Oscilous/Ladybug/README.md

# Ladybug
SDU 4th semester project group 6
Members:
Tobias
Artis
Johan
Thor
Ruta
Choyon
