Oscilous/Ladybug/LaTeX/Report/main.tex

\documentclass[a4paper,12pt]{article}
\usepackage[a4paper, top = 2.5cm, bottom = 2.5cm, left = 2.5cm, right = 2.5cm]{geometry}
\usepackage{graphicx} % Required for inserting images
\usepackage{float}
\usepackage{setspace}
\usepackage{url}
%\usepackage{minted}
\usepackage{booktabs}
\usepackage{geometry}
\usepackage{parskip}
\usepackage{ragged2e}
\usepackage{subfig}
\usepackage{cite}
\usepackage[svgnames, dvipsnames]{xcolor}
\usepackage{tikz}   
\usepackage{makecell, tabularx}
    \setcellgapes{2pt}
    \makeatletter
    \newcommand*{\compress}{\@minipagetrue}
    \makeatother
    \newcolumntype{I}{ >{\RaggedRight\compress\itemize}X<{\enditemize}}
    \newcommand*{\mcl}[1]{\multicolumn{1}{l|}{#1}}
\usepackage[skip=1ex]{caption}
\usepackage{enumitem}\usepackage{tabularx}
\usepackage[utf8]{inputenc}
\usepackage[T1]{fontenc}
\usepackage{amsmath}
\usepackage{pdfpages}
\usepackage{wrapfig}

\graphicspath{ {./pictures/} }
\onehalfspacing

\begin{document}

\begin{titlepage}

\begin{tikzpicture}[remember picture,overlay]
   \node[anchor=south east,inner sep=20pt] at (current page.south east)
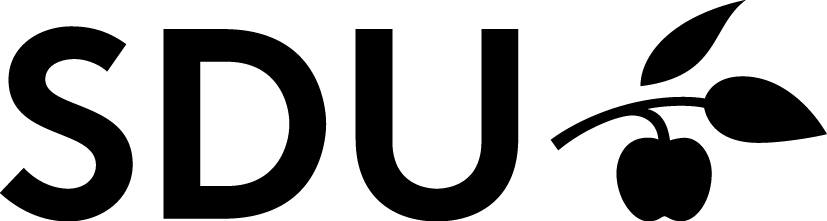
[picture p1: LaTeX/Report/pictures/sdulogo.jpg]
              {};
\end{tikzpicture}

\begin{center}

\noindent \textbf{BEng Mechatronics}

\noindent \textbf{University of Southern Denmark Sønderborg}

\Huge \bfseries{Semester Project 4 - Ladybug}

\end{center}

\begin{center}

\vspace*{0.1cm}

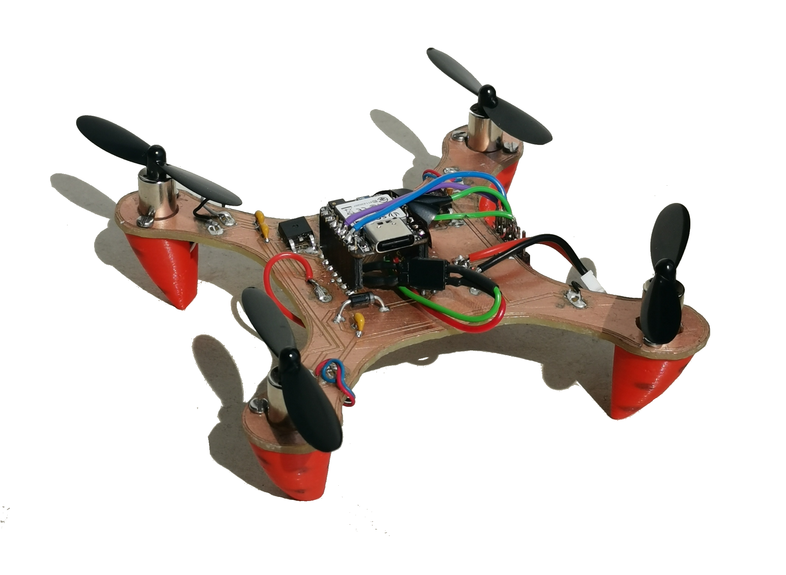
[picture p2: LaTeX/Report/pictures/FPP.png]
	

	\noindent \textbf{Ruta Miglava, }
	\noindent \textbf{Johan Paul, }
	\noindent \textbf{Choyon Mainul Hasan, }
	\noindent \textbf{Thor Uerkvitz, }
	\noindent \textbf{Artis Fils, }
	\noindent \textbf{Tobias Blaabjerg Karlsen}

	\vspace*{2cm}

\end{center}

\begin{center}

	\noindent \textbf{Supervised}
	\noindent \textbf{By}
	\vspace*{0.1cm}

	\noindent \textbf{Lars Duggen}

	\noindent \textbf{Davi Goncalves Accioli}

	\vspace*{1.5cm}

	\noindent \textbf{June 2023}	

\end{center}

\end{titlepage}

\tableofcontents
\newpage

\include{introduction/background.tex}
\input{introduction/problem_statement.tex}
\input{introduction/morpho.tex}
\input{introduction/evaluation_matrix.tex}
\input{introduction/risk_assesment.tex}

\include{software/github.tex}
\input{design/Drone_body.tex}
\input{control/plant_equations.tex}
\input{control/Controller.tex}
\input{control/uavtoolbox.tex}
\input{control/theoryofpid.tex}
\input{control/linearization.tex}
\input{control/simulationofpid.tex}
\input{control/pid.tex}

\input{IMU/IMU.tex}

\include{software/embeded.tex}
\input{software/quickpid.tex}
\input{software/logging.tex}
\input{software/Wireless.tex}
\input{software/flow.tex}
\include{conclusion/conclusion.tex}
\pagebreak
\bibliographystyle{plain}
\bibliography{references}

\appendix
\include{control/thrust_experiments.tex}
\include{control/Motor_Testing.tex}       
\include{introduction/Budget.tex}
\include{software/zephyr.tex}
\include{control/Plant_equations_appendix.tex}
\end{document}
