Oscilous/Ladybug/LaTeX/Report/control/plant_equations.tex

\section{Control prototyping}
\subsection{Plant Model Equations}\label{plant_eq}
This section of the report will explain how the plant model equations are obtained. Followed by how these equations are implemented in MATLAB/Simulink.

The plant model is a series of equations with multiple variables, which uses inputs, states, and parameters to get a certain output. 
For this project, the plant model is designed to take a height input the drone should hover at, paired with the inputs from the sensors, to achieve the desired hover height and stability.

\subsubsection{State Equations}
The drone possesses 6 degrees of freedom, enabling it to navigate in various directions and perform rotations. It can move along the X, Y, and Z axes, while also being capable of pitch (rotation around the Y axis), roll (rotation around the X axis), and yaw (rotation around the Z axis). The precise angle and position of the drone can be defined at any time by identifying the axis of rotation and its accompanying state variables.
\cite{Ferry}

\begin{figure}[H]
\begin{center}
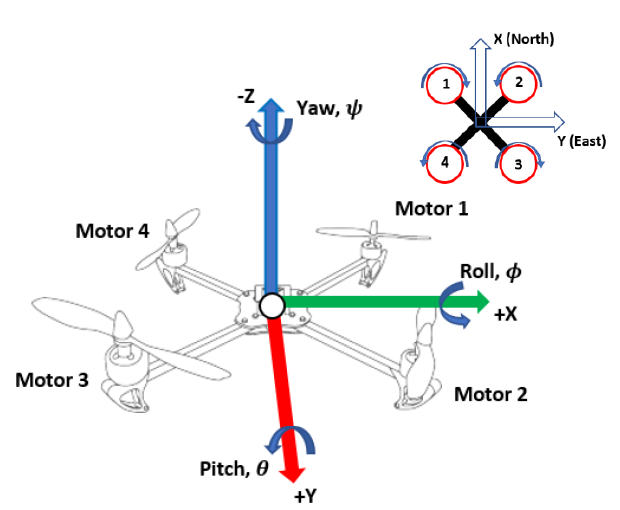
[picture p8: LaTeX/Report/pictures/control/drone directionals.png]
    
\end{center}
\caption{Quadcopter 'x' configuration \cite{Ferry}}
\end{figure}

The drone's states include critical physical properties like acceleration, velocity, and position, which are all detected by sensors. A gyroscope is used to record the angular changes of the drone. An accelerometer is a device that measures acceleration along the X, Y, and Z axes. Since the gyroscope drifts and the accelerometer has measurement spikes when subjected to high acceleration, a complementary filter will be needed, which will be discussed in the “IMU” subsection. A dedicated infrared sensor is also used to measure distances in the Z-direction, allowing for exact location information.
A state table can be found in Appendix E.

Before plant model equations can be generated, parameters for the drone need to be calculated. The parameters are what explains the drone mathematically and are an integral part of modelling the drone. The more accurate these values are the more realistic the plant model will be.
The parameters needed can be seen in the table below:\cite{Ferry}

\begin{figure}[H]
\begin{center}
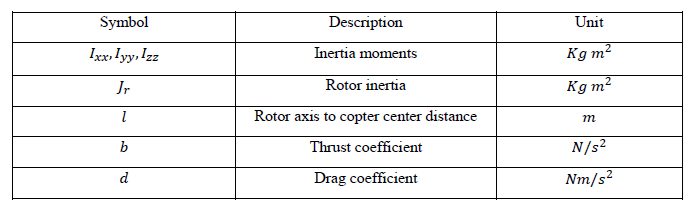
[picture p9: LaTeX/Report/pictures/control/parameter table.png]
    
\end{center}
\caption{State table}
\end{figure}

\subsubsection{Inertia Moments}
A moment of inertia is a constant value that explains the force/torque required to rotate an object in the direction of the moment. A desired angular velocity around a rotation axis can be found. The moments of inertia are found using estimation. If it is assumed that the drone is symmetrical in all axis, the moments of inertia can be found using parallel axis theorem to approximate the moments for each individual part of the drone in the X, Y, Z directions. For the calculations it’s assumed that the centre of mass for the drone is perfectly in the centre of the drone’s body.
The equations used for each individual part of the drone can be found in \cite{Ferry}.

For the approximation smaller electrical components were not considered, such as wires and mosfets, since their collective total weight is less than a gram, they are deemed negligible for the accuracy estimation.

\begin{figure}[H]
\begin{center}
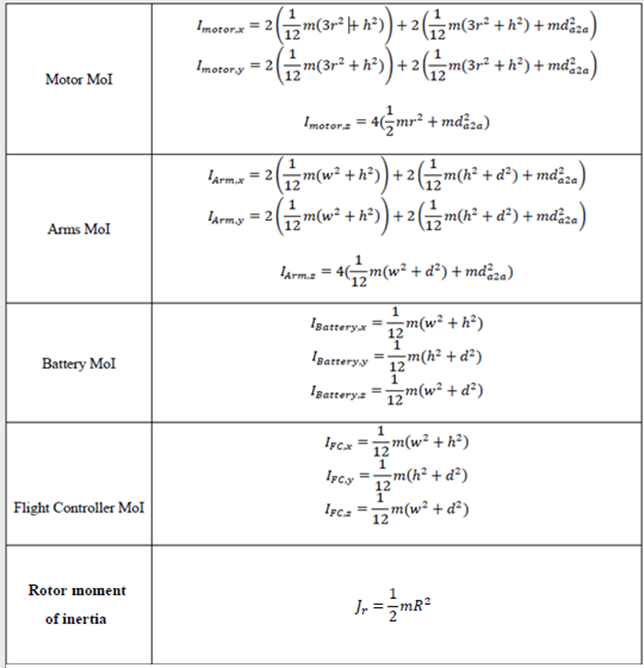
[picture p10: LaTeX/Report/pictures/control/inertia tables table.png]
   
\end{center}
\caption{Inertia moment equations \cite{Ferry}}
\end{figure}

A mathematical document can be found as a hand-in attachment “SPRO4math”. It shows the detailed process of calculation.
\begin{figure}[H]
\begin{center}
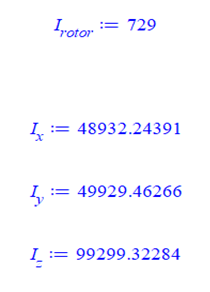
[picture p11: LaTeX/Report/pictures/control/Inertia moments.png]
   
\end{center}
\caption{Moments of inertia in the X, Y, Z axis, in $g*mm^2$ as calculated from equations, used in the final version of the quadcopter}
\end{figure}

\subsubsection{Characterization of Motor}
Some drone parameters can not be determined due to a lack of data concerning the motors used in the project. The motors are of a commercial product, but with no available data sheet. This means that motor constants and thrust coefficients need to be determined through testing. 
The next part of the report is a small summary of the tests done to determine the data needed for the motors. The full reports concerning testing and acquiring these values can be found in the appendix. 
\begin{itemize}
    \item Thrust testing can be found in appendix \ref{appendix_thrust}.
    \item Motor constant testing can be found in appendix \ref{Motor Testing_Appendix}.
\end{itemize}

\subsubsection{Thrust testing}

For thrust testing the motor is placed in a frame on a scale to measure the change in weight when the motor is operating. A sketch of the setup can be found in appendix \ref{appendix_thrust}2.2. The motor used had an operating voltage window of 0-4,2 volts, therefore the motor was tested between 1-4,2 volts incremented with 0,1 volts, and the weight change noted for each increment. Characterizing the motor yielded the results seen in figure \ref{motorthrustgraphed}. As a general rule of thumb, provided by project supervisors, the motor's need to produce double the thrust of the total weight of the drone to operate ideally. At maximum voltage level of the battery, a single motor produces 22.2 grams of thrust. In conclusion, at maximum voltage level the drone can ideally weigh 44.4 grams in total. The battery will slowly discharge meaning that it's impossible to always have max output, so it should be a little less than 44.4 grams in practice.

\begin{figure}[H]
\begin{center}
   
\end{center}
\caption{Motor Thrust Graphed}
\label{motorthrustgraphed}
\end{figure}

\subsubsection{Motor Constants, and Thrust Coefficient}
Motor constants relevant for this project include, “Motor velocity constant” ($K_v$) and “Motor torque constant” ($K_T$)
With a simple setup the motor's RPM can be tested proportionally to PWM. The motor was tested in 20 increments, using a photo sensor to measure RPM. Using the data from the test, the result is shown in figure \ref{motorconstantscals}. \cite{MotorConstants}

\begin{figure}[H]
\begin{center}
   
\end{center}
\caption{Equations used for calculating thrust- and velocity constants}
\end{figure}

\begin{figure}[H]
\begin{center}
   
\end{center}
\caption{Motor Constants}
\label{motorconstantscals}
\end{figure}

Combining the two test data sets it is possible to determine the thrust coefficient of the motor. Using the graph from the thrust test, the thrust can be calculated by taking the voltage drop over the motor. This thrust is then divided with the angular velocity to get the thrust coefficient ($TC=3.59E-05$).

The constants/coefficients are calculated around 3.0V inputs, which is the voltage needed to achieve the theoretical hover thrust. This is sensible since most of the time the drone will be operating around these values. 

\subsubsection{Environmental Forces}
The drone is very small, weighing only approximately 60 grams with little surface area. Because of this, aerodynamic effects have been neglected for the modelling. Environmental forces mainly include but are not limited to wind resistance and liftoff turbulence.

\subsubsection{Generating Plant Model Equations}
Now with the all the states and parameters defined, plant model equations can be generated. 
First, it is considered how the motors should operate together to move the quadcopter in the desired direction. A quadcopter can move in X and Y directions using pitch and roll. When the quadcopter rotates around one of its axis, all the rotor blades will generate thrust at an angle, moving the drone in a direction. It is important to control the individual motors so the drone won’t tilt too much, causing it to flip in the air. In figure \ref{ter} below the different cases of directional movement for the quadcopter can be seen.  

\begin{figure}[H]
\begin{center}
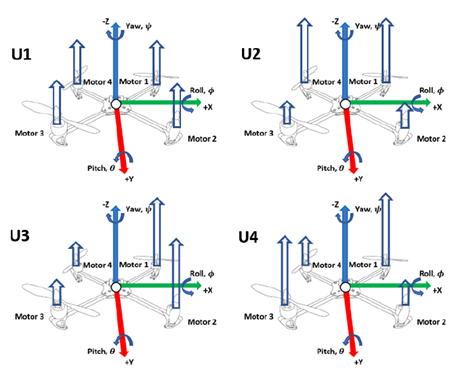
[picture p12: LaTeX/Report/pictures/control/thrust equations results.png]
   
\end{center}
\caption{Visual representation of thrust equations \cite{Ferry}}
\label{ter}
\end{figure}

In figure \ref{ter} U1 is the general thrust behaviour, providing thrust equally and symmetrically to move only the Z axis. U2 creates a roll, thrusting the drone in the Y direction. U3 creates a pitch, thrusting the drone in the X direction. U4 increases the thrust for motors turning the same direction and decreases the thrust of the motors rotating the opposite direction, allowing the drone to rotate in the Z axis e.g., yaw due to non-symmetrical rotational forces created by the moments of the motors.  \cite{Ferry}

Each motor's thrust is then defined as angular rotational speed to acquire the following equations.

\begin{figure}[H]
\begin{center}
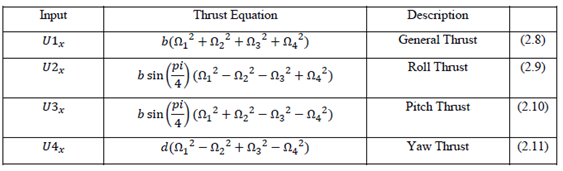
[picture p13: LaTeX/Report/pictures/control/thrust equations.png]
   
   
\end{center}
\caption{Thrust equations \cite{Ferry}}
\end{figure}

The plant equations for this project were sourced from \cite{Ferry}. The source has a more in depth description of how the plant equations were found.
A summary of all the plant equations can be found in appendix \ref{appendix_plant}.

\begin{figure}[H]
   \begin{center}
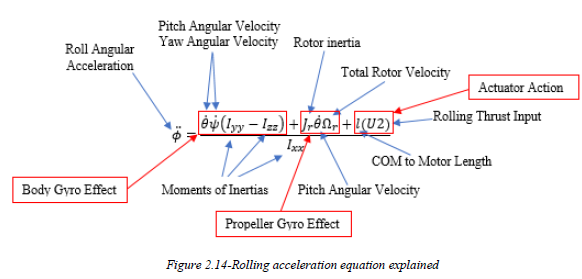
[picture p14: LaTeX/Report/pictures/control/plant equation example.png]
      
   \end{center}
   \caption{Example of plant equation for phi. \cite{Ferry}}
   \end{figure}
Body gyroscopic effects from changes in the quadcopter orientation.
Propeller gyroscopic effects from propeller rotation and angle/orientation.
Actuation action forces produced by the rotors/propellers.

\subsubsection{SIMULINK/Matlab Implementation}
To make the Simulink model the thrust equations must be transferred into the program using the angular speed as inputs and the motor parameters. Below the thrust equations can be seen in Simulink with the inputs on the left and outputs on the right. (The outputs are U1, U2, U3, and U4, as well as Omega) In SIMULINK the math is done using “blocks”, the addition and subtraction is performed first, and then the next blocks take the product. Essentially the math is converted using blocks in SIMULINK.

\begin{figure}[H]
\begin{center}
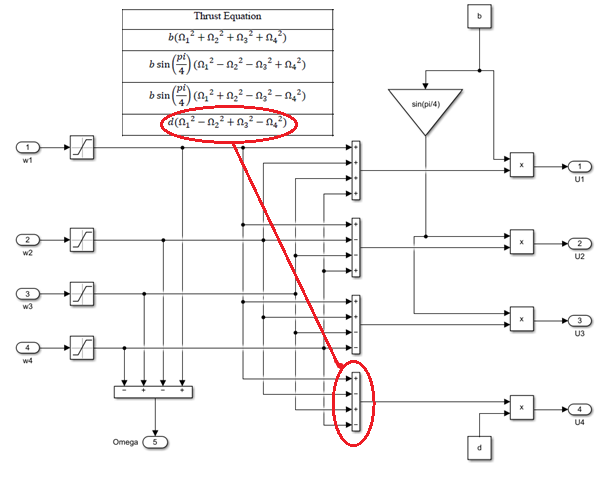
[picture p15: LaTeX/Report/pictures/control/thrust equation in simulink.png]
   
\end{center}
\caption{Thrust equations in SIMULINK}
\end{figure}

The rest of the plant equations are then also transferred to SIMULINK using the same process, using blocks to represent the math. The next part of the plant takes the thrust equations as an input to calculate theta, phi, and psi, for position, velocity, and acceleration.

Below is an example for the equation of phi double dot. The thrust equations were used alongside feedback with the drone parameters to get the result. Since all the equations need feedback from the other plant equations, an initial value must be set. It makes sense to make the initial value 0 since it hasen't moved yet and there has been no change in any direction or angle. Throughout the flight the drone will then fill out the theta, phi, and psi values using the sensors to determine the change in position. For example, if the drone is slanted a bit in the direction of motor 4 and 1, the drone will have a change in the roll aka phi value. The sensor will detect the magnitude of this change, and U2 will increase to give more thrust to those motors to stabilize. Thrust is increased proportionally in order smoothen the stabilization. 

\begin{figure}[H]
\begin{center}
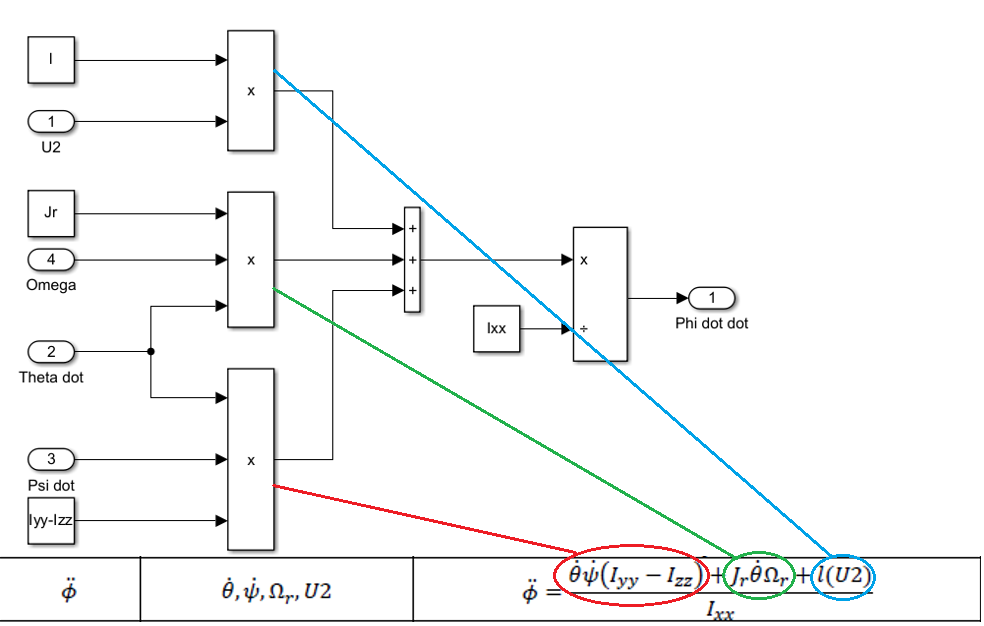
[picture p16: LaTeX/Report/pictures/control/plant equation phi example.png]
   
\end{center}
\caption{Plant equation for phi double dot}
\end{figure}

\begin{figure}[H]
\begin{center}
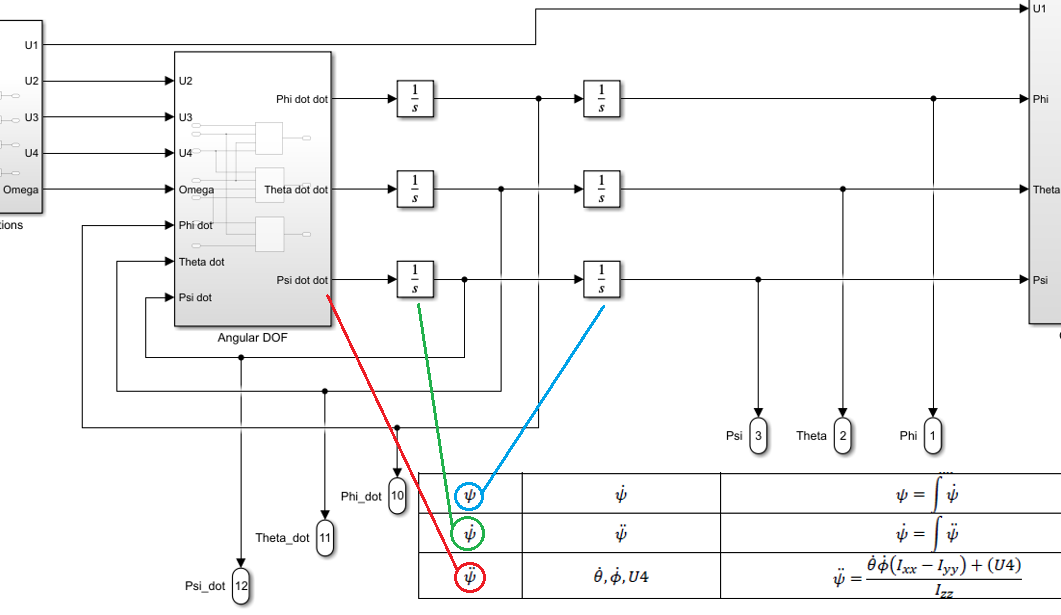
[picture p17: LaTeX/Report/pictures/control/plant pic1.png]
   
\end{center}
\caption{Angular equations overview example}
\end{figure}

To finish out the plant, the X, Y, and Z values for acceleration, velocity, and position are calculated using the values from theta, phi, and psi, these equations rely on feedback from each other in the same way that angles do, and use the same principles when it comes to determining the initial value. 

\begin{figure}[H]
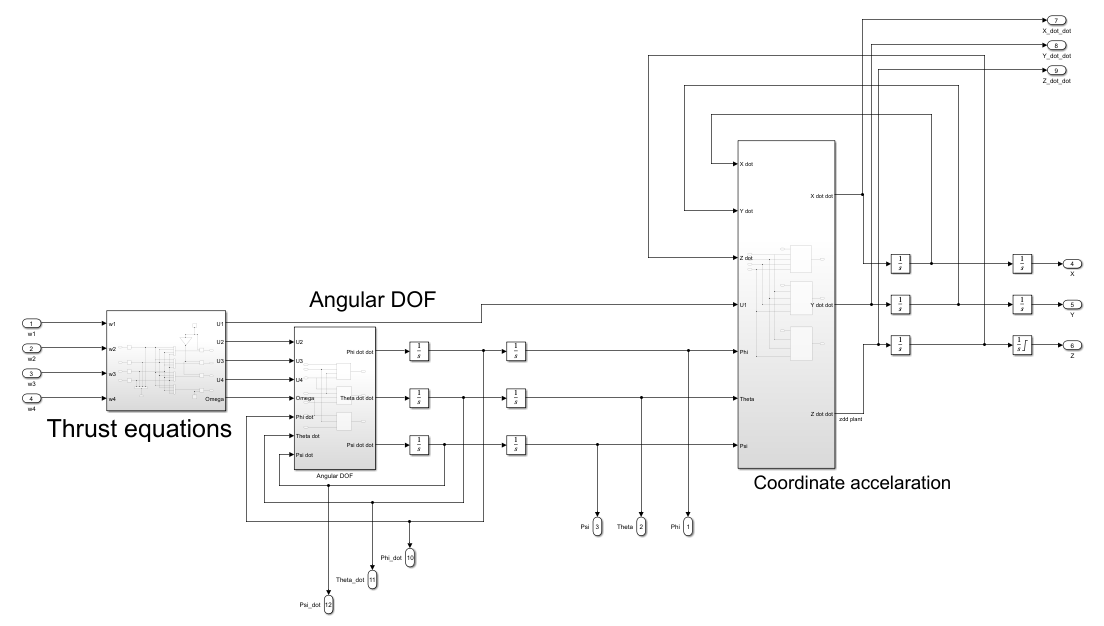
[picture p18: LaTeX/Report/pictures/control/Plant overview.png]
   
\caption{Plant overview in SIMULINK}
\end{figure}
