Oscilous/Ladybug/LaTeX/Report/software/Wireless.tex

\subsection{Wireless communication}
When prototyping, quadcopters are able to easily disconnect their wired connection. Therefore if mid-air communication is required, it is necessary to have wireless communication.

Commonly used communication for drones are primarily various forms of 2.4 GHz protocols, as it provides the best middle ground between reach and speed. The 2.4 GHz has wide range of technologies supporting it, for example, Bluetooth, Wi-Fi and RF communication protocols. 
If a high performance drone was the goal, RF communication would have been chosen, but for the purpose of this project Bluetooth or rather BLE is optimal, as the microchip has inbuild capability of BLE, which stands for Bluetooth low energy. BLE has lower power requirements, as it is primarly one way communication, where the packets are not being sent constantly, but only when needed or requested.

The implementation of BLE for nRF52840 in Arduino IDE usually relies on either Bluefruit LE or Adafruit BLE library, depending on whether pure C or Mbed is used.
For a device to use BLE, it needs to be either peripheral, which advertises itself or central, which connects to the advertised peripheral. Peripheral has services, for example control service, which can have characteristics like state with 0 and 1 for turning on and off.
This characteristic can have different options. Write, where the central writes to this characteristic, read if central reads from it and notify which lets the central know, that it changed. Also a combination of these can define each characteristic.

In this case, the drone was chosen as a peripheral with characteristics mentioned above. A controller with a joystick and two buttons connects to the peripheral as the central and writes to the characteristics. This was not used in the project, as the project did not reach stages requiring advanced remote control.
 
Instead, there is a kill-switch. This was made for the initial free-flight testing. It contains only one characteristic, which switches between 0 and 1 no matter what it receives, which starts the drone on 0 and stops on 1. It can be controlled from a mobile phone. The option of sending gyro-data from a phone to the drone to mimic a controller was also explored, but required packet management, as the data packets sent were too long.

Last option which was explored was logging data through BLE. The challenging part is that BLE is aimed mainly at mobile device and proprietary applications. Therefore there are no available applications for Windows which allow reading data from BLE devices and mobile phone applications do not offer the option of saving larger amounts of data. As a consequence of mentioned, data-logging through BLE was abandoned.
