Oscilous/Ladybug/LaTeX/Report/control/Plant_equations_appendix.tex

\section{Plant Appendix}\label{appendix_plant}

\begin{figure}[H]
   \begin{center}
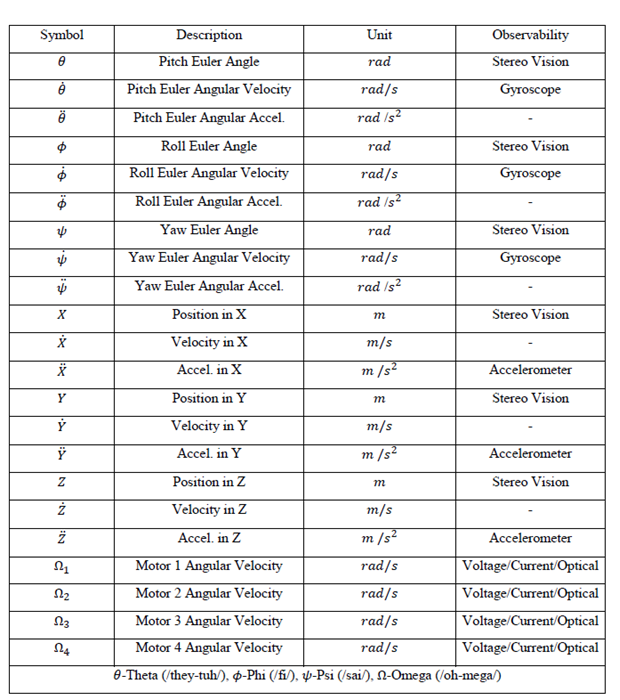
[picture p71: LaTeX/Report/pictures/control/State table.png]
       
   \end{center}
   \caption{State table \cite{Ferry}}
   \end{figure}

\begin{figure}[H]
    \begin{center}
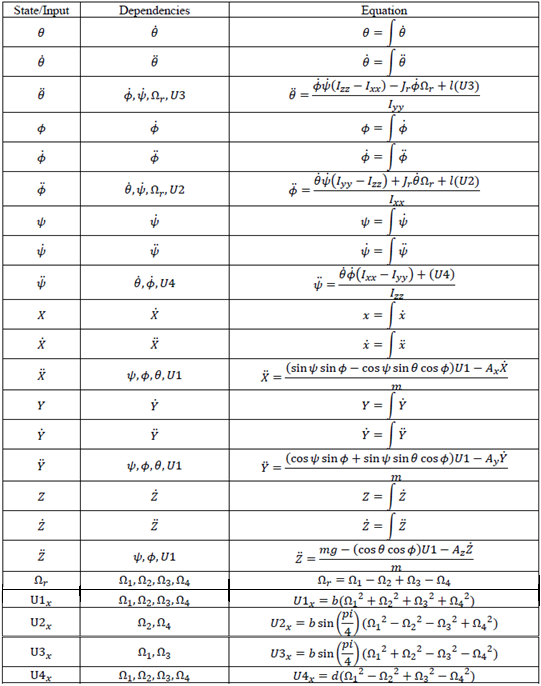
[picture p72: LaTeX/Report/pictures/control/plant equations.png]
       
    \end{center}
    \caption{Summary of plant equations \cite{Ferry}}
\end{figure}
