Oscilous/Ladybug/LaTeX/Report/introduction/morpho.tex

\subsection{Morphology table}

In this section the morphology table is provided where the specific functions of the product and their potential solutions are provided. Three different possibilities for a combination of solutions were chosen in total and they are marked with the following respective colours.

\begin{figure}[H]
    \begin{center}
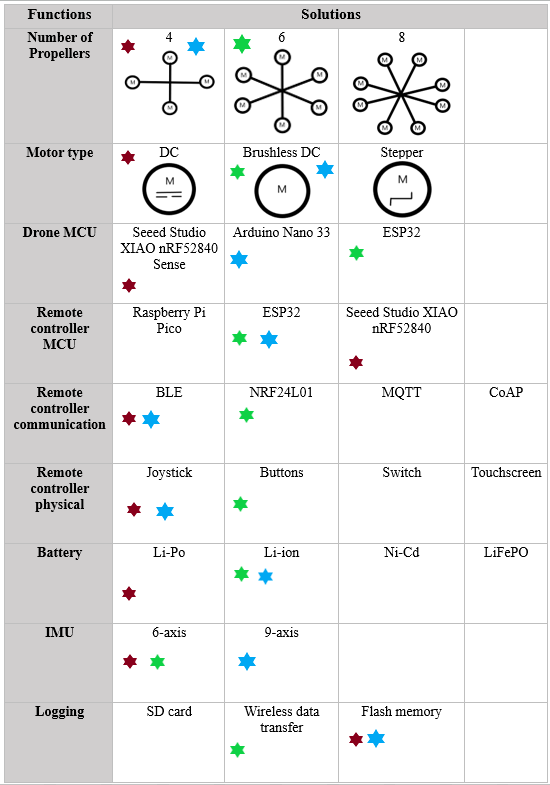
[picture p74: LaTeX/Report/pictures/Morphology_with_solutions.png]
    
    \end{center}
    \caption{Morphology table for quadrotor design}
    \label{fig:morphology}
\end{figure}
