Oscilous/Ladybug/LaTeX/Report/IMU/IMU_old.tex

\documentclass{article}
\usepackage{graphicx} % Required for inserting images
\usepackage{float}

\begin{document}

\section{IMU overview}

Inertial Measurement Unit is a key component of the drone control as it provides feedback about the position in time which is crucial for adjusting the control input signal.

As described in the morphology for our project we have chosen to use the inbuilt IMU sensor with 6DOF available on the Seeed Xiao Sense micro-controller board. Since incoming signal noise is a concern, it is beneficial to use an inbuilt component in an effort to reduce the interference on IMU readings.

The IMU consists of a gyroscope that provides angular velocity
data and an accelerometer providing axial acceleration data.

\begin{figure}[H]
    \begin{center}
    
    \end{center}
    \caption{Gyroscope and Accelerometer internal axis}
    \label{fig:my_label}
\end{figure}

Each gyroscope channel measures the rate of rotation around one of the internal axes in degrees per second (as our gyroscope has an inbuilt ADC unit, the actual output will be in bits that can be re-interpreted as degrees per second). With these readings, the angular position can be calculated by integrating the gyroscope measurements over time. If the angular velocity is denoted by $\dot{\Theta}$, the angle of rotation can be calculated as follows:

\begin{figure}[H]
    \begin{center}
    
    \end{center}
    \caption{Integration of gyroscope readings}
    \label{fig:my_label}
\end{figure}

To better understand the accelerometer readings we can imagine a box with a ball inside of it. In zero gravity conditions the ball would be floating in the air and no force on any of the walls would be detected.

\begin{figure}[H]
    \begin{center}
    
    \end{center}
    \caption{Accelerometer, zero gravity}
    \label{fig:my_label}
\end{figure}

If the box was moved in positive X axis direction with acceleration of $9.81 m/s^2$, the ball would hit the wall of the box in negative X axis direction and register force of $1g$. From this we can note that accelerometer is reading a force in the opposite direction of the motion. 

\begin{figure}[H]
    \begin{center}
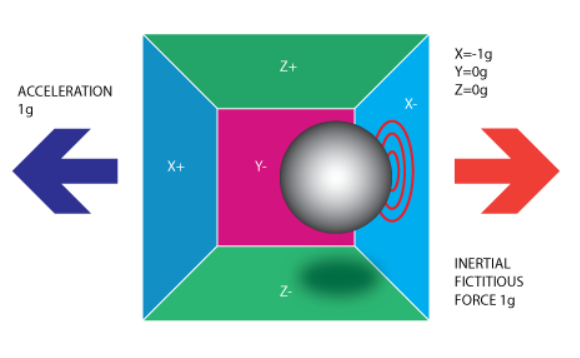
[picture p75: LaTeX/Images/Accel_x_motion.png]
    
    \end{center}
    \caption{Accelerometer, Motion in positive X axis direction}
    \label{fig:my_label}
\end{figure}

Similarly we can now imagine that when the box is siting still in gravitational field of the Earth, we would get a reading of $1g$ in the downwards Z axis direction. If the IMU was rotated in respect to Earth surface, the reading of 1g would be split into x, y and z components on the accelerometer internal axis. We can use these readings to calculate the positional angles with respect to earth surface with the help of the following formula.

\begin{figure}[H]
    \begin{center}
    
    \end{center}
    \caption{Positional angle calculation   }
    \label{fig:my_label}
\end{figure}

It is important to note that all measurements on accelorometer are read in the IMU body frame. In order to relate them to Earth's surface we need to choose a reference coordinate system and relate the measurements from the body reference frame to the chosen coordinate system.

For our model we have chosen to work with NED (north-east-down) coordinate system, where X axis is pointing to north, the y‐axis to east, and the z‐axis is pointing down.

\begin{figure}[H]
    \begin{center}
    
    \end{center}
    \caption{NED coordinate system}
    \label{fig:my_label}
\end{figure}

In order to relate sensor readings from body reference frame to NED, we are using Euler angles, which provide a way to represent the 3D orientation of an object using a combination of three rotations about different axes. Rotation about X axis is denoted by $\Phi$, rotation about Y with $\Theta$ and rotation around Z axis with $\Psi$. 

\begin{figure}[H]
    \begin{center}
    
    \end{center}
    \caption{Euler angles}
    \label{fig:my_label}
\end{figure}

Any object rotation can be described by multiplying a rotational matrix with the original position vector. Any rotation matrix R can be decomposed as a product of three elemental rotation matrices - roll, yaw and pitch.\newline

$Roll = \left(\begin{array}{ccc}
1 & 0 & 0\\
0 & \cos \left(\Phi \right) & -\sin \left(\Phi \right)\\
0 & \sin \left(\Phi \right) & \cos \left(\Phi \right)
\end{array}\right)$

$Pitch = \left(\begin{array}{ccc}
\cos \left(\Theta \right) & 0 & \sin \left(\Theta \right)\\
0 & 1 & 0\\
-\sin \left(\Theta \right) & 0 & \cos \left(\Theta \right)
\end{array}\right)$

$Yaw = \left(\begin{array}{ccc}
\cos \left(\Psi \right) & -\sin \left(\Psi \right) & 0\\
\sin \left(\Psi \right) & \cos \left(\Psi \right) & 0\\
0 & 0 & 1
\end{array}\right)$\newline

The complete rotation matrix for moving from the NED frame to the body frame is achieved by first performing Yaw then Pitch then Roll resulting in the following rotation matrix
($R(\left(\Phi \right , \left\Theta \right , \left\Psi \right )):$
\newline
\newline
 $\left(\begin{array}{ccc}
\cos \left(\Psi \right)\,\cos \left(\Theta \right) & -\cos \left(\Theta \right)\,\sin \left(\Psi \right) & \sin \left(\Theta \right)\\
\cos \left(\Phi \right)\,\sin \left(\Psi \right)+\cos \left(\Psi \right)\,\sin \left(\Phi \right)\,\sin \left(\Theta \right) & \cos \left(\Phi \right)\,\cos \left(\Psi \right)-\sin \left(\Phi \right)\,\sin \left(\Psi \right)\,\sin \left(\Theta \right) & -\cos \left(\Theta \right)\,\sin \left(\Phi \right)\\
\sin \left(\Phi \right)\,\sin \left(\Psi \right)-\cos \left(\Phi \right)\,\cos \left(\Psi \right)\,\sin \left(\Theta \right) & \cos \left(\Psi \right)\,\sin \left(\Phi \right)+\cos \left(\Phi \right)\,\sin \left(\Psi \right)\,\sin \left(\Theta \right) & \cos \left(\Phi \right)\,\cos \left(\Theta \right)
\end{array}\right)$\newline

To transition from body reference frame to NED, we need to perform the rotations in opposite order - Roll, then Pitch, then Yaw from negative angles ($R( -\left\Psi \right, -\left\Theta \right ,-\left\Phi \right )):$ \newline
\newline
$\left(\begin{array}{ccc}
\cos \left(\Psi \right)\,\cos \left(\Theta \right) & \cos \left(\Phi \right)\,\sin \left(\Psi \right)+\cos \left(\Psi \right)\,\sin \left(\Phi \right)\,\sin \left(\Theta \right) & \sin \left(\Phi \right)\,\sin \left(\Psi \right)-\cos \left(\Phi \right)\,\cos \left(\Psi \right)\,\sin \left(\Theta \right)\\
-\cos \left(\Theta \right)\,\sin \left(\Psi \right) & \cos \left(\Phi \right)\,\cos \left(\Psi \right)-\sin \left(\Phi \right)\,\sin \left(\Psi \right)\,\sin \left(\Theta \right) & \cos \left(\Psi \right)\,\sin \left(\Phi \right)+\cos \left(\Phi \right)\,\sin \left(\Psi \right)\,\sin \left(\Theta \right)\\
\sin \left(\Theta \right) & -\cos \left(\Theta \right)\,\sin \left(\Phi \right) & \cos \left(\Phi \right)\,\cos \left(\Theta \right)
\end{array}\right)$\newline

\section{Sensor fusion}
Now that we have established two methods of obtaining angular position, we must take into account the deficiencies related to each of the methods. The accelerometer gives good accuracy when the drone is not accelerating and the only acceleration we are reading is from gravity.
The gyroscope can read quick movements but since the readings are being integrated, any error in the measurements is repeatedly added to the calculated position thereby leading to a drifting signal.

The solution is to introduce either a filter or an observer to fuse the measurements from accelerometer and gyroscope. For our project we have implemented a complimentary filter consisting of a low pass filter on the accelerometer and a high pass filter on gyroscope and summing the filtered signals. \newline
The transfer functions of low pass and high pass filters in s domain are given below (where $\tau$ is the time constant and $\omega _o$ is the angular cutoff frequency in $rad/s$):\newline 

\center $H(s) = \frac{V_o_u_t(s)}{V_i_n(s)} = \frac{\omega_0}{(s+\omega_0)}= \frac{1}{\tau s+1}$
\center $H(s) = \frac{V_o_u_t(s)}{V_i_n(s)} = \frac{s}{(s+\omega_0)}= \frac{\tau s}{\tau s+1}$

\begin{flushleft}
Cutoff frequency in Hz:
\end{flushleft}
$f_c=\frac{\omega _o}{2\pi}$
\newline
\begin{flushleft}
Since the filter will be digital, the real time transfer function needs to be discretized by moving to z domain. This can be done with the help of Bilinear transform (Tustin's method), with the following substitution (where $T_s$ is the sampling time):
\end{flushleft}
$s=\frac{T_s}{2}\frac{1-z^-^1}{1+z^-1}$

\begin{flushleft}
 This results in discrete transfer function: 
\end{flushleft}

$H(z)= \frac{\omega _o}{\frac{T_s}{2}\frac{1-z^-^1}{1+z^-1} + \omega _o}=\frac{b_o + b_1z^-^1}{1-a_1z^-^1}$

\begin{flushleft}
Giving us discrete time implementation of:  
\end{flushleft}
$y(t)=a_o y_n_-_1+b_ox_n+b_1x_n_-_1  $

\begin{flushleft}
To calculate the coefficients $a_o, b_o, b_1$ we can use Matlab Transfer function $tf()$ and Continuous to discrete time function $c2d() $
\end{flushleft}

\begin{figure}[H]
    \begin{center}
    
    \end{center}
    \caption{Bilinear transform in Matlab}
    \label{fig:my_label}
\end{figure}

\begin{flushleft}
The sampling time $T_s$ used in calculations is the loop time of the code we run on the microcontroller.

After the calculated angles are passed through their respective filters, the values can be summed up resulting in a complimentary filter (as shown in the visual below):
\end{flushleft}

\begin{figure}[H]
    \begin{center}
    
    \end{center}
    \caption{Complimentary filter implementation in discrete time}
    \label{fig:my_label}
\end{figure}

\section{Simulink}
\begin{flushleft}
To simulate the IMU readings as feedback in Simulink we first need to consider what input variables will be handled be the gyroscope and the accelerometer plants. The drone plant in the simulation is operating in NED reference frame, therefore any outputs coming from it are also in NED. However the physical IMU will be handling measurements in body reference frame, therefore we need to create a function block to transform the drone output values into body reference frame values. 

For the accelerometer this can be done by taking all linear motion acceleration outputs from drone plant in the form of a column vector $Acc=($X'', Y'', Z''$)$ and multiplying it with the rotational matrix for moving from NED to body. This equation requires knowing the Euler angles to be used in the rotational matrices. Luckily these values can also be taken from the drone plant.

\begin{figure}[H]
    \begin{center}
    
    \end{center}
    \caption{Rotational transformation from NED to body ref. frame, Matlab}
    \label{fig:my_label}
\end{figure}

\begin{figure}[H]
    \begin{center}
    
    \end{center}
    \caption{NED to body transformation function block, Simulink}
    \label{fig:my_label}
\end{figure}

Since the gyroscope is handling angular velocities rather than the positional angles we do not need to perform rotational transformation on these values as they are be the same in both reference systems. Therefore we can use the angular velocity output($\dot{\Phi}, \dot{\Theta}, \dot{\Psi}$,) from the drone plant as the input for the gyroscope plant. 

In the simulation both accelerometer and the gyroscope plants are reading the ideal values from the drone plant, however in the physical model there would be noise present therefore we need to generate noise by adding a random number generator on the incoming signals. In the physical IMU there is also a bias on the readings, which can be measured and subtracted from the readings.

\begin{figure}[H]
    \begin{center}
    
    \end{center}
    \caption{Gyroscope plant in Simulink}
    \label{fig:my_label}
\end{figure}

The IMU readings are then passed through the Complimentary filter plant, where gyroscope readings are used to calculate positional angles via integration and passed through a high pass filter and the angles calculated from accelerometer readings are passed through a low pass filter. For the high pass filter the transfer function used is $\frac{T_h_i_g_h*s}{T_h_i_g_h*s+1}$ where $T_h_i_g_h$ is the period of the cutoff frequency of the filter $T_h_i_g_h=\frac{1}{f_c}$

\begin{figure}[H]
    \begin{center}
    
    \end{center}
    \caption{Complimentary filter plant in Simulink}
    \label{fig:my_label}
\end{figure}

The complimentary filter plant also includes calculation of vertical position $Z$ by performing double integration of the vertical acceleration reading. In the physical model we have included a time of flight sensor for this measurement, however it is not included in the simulation as the sensor was a later addition. In ideal scenario we would also include a sensor that could be used as additional reference for the Yaw, for example, a magnometer, as only using the gyroscope reading to track this angle introduces drift. Unfortunately we only have an IMU with 6DOF. 
The filtered values are then converted back to NED reference frame by using calculations described previously and then passed back as feedback input for the control plant.

\begin{figure}[H]
    \begin{center}
    
    \end{center}
    \caption{IMU plant in Simulink}
    \label{fig:my_label}
\end{figure}

\end{flushleft}

\section{IMU code}

\begin{flushleft}
To obtain the IMU readings from our sensor we first need to establish connection with the microcontroller board and luckily using Arduino IDE makes this simple by offering Seeed Studio XIAO nRF52840 (Sense) board package. Additionally we need to include several libraries, such as math.h and LSM6DS3.h. 

The LSM6DS3.h pre-defines the I2C address as 0x6B but can be overwritten in code - as in our case the address is in fact 0x6A. 
The library also pre-defines IMU settings - enables both sensors and sets Gyro and Accelerometer sampling rate as 416 Hz. This means sampling time for IMU readings of 2.4 ms, which works with the code for drone control as the sampling frequency is higher than control input calculation frequency. 

By default the maximum range is selected for both sensors - 16g for Accelerometer and 2000 dps for the Gyro. The library also conveniently performs the necessary calculations and returns the measurements in gravitational constants and degrees per second and sensor readings can be accessed by using functions readFloatGyroX() and readFloatAccelX().  

\begin{figure}[H]
    \begin{center}
    
    \end{center}
    \caption{Default settings in LSM6DS3.h library}
    \label{fig:my_label}
\end{figure}

\begin{flushleft}
The IMU offers inbuilt analog Low Pass and High pass filters, however we have chosen not to use them and to only rely on the digital filters implemented by us.

There are two important additional sensor initiation steps that are not covered by the library - removing sensor bias and aligning the internal axis of the Gyro and Accelerometer units. 

To calibrate the sensor, we use a simple $for$ loop that runs 10 000 iterations reading the sensor output and averages the values. Since we know that when the sensor is standing still, we should be reading 0 angular velocity, we can subtract these average readings from every future reading, thus creating the ReadGyro() function. 
\end{flushleft}

\begin{figure}[H]
    \begin{center}
    
    \end{center}
    \caption{Gyro calibration}
    \label{fig:my_label}
\end{figure}

\begin{figure}[H]
    \begin{center}
    
    \end{center}
    \caption{read_gyro_f() function}
    \label{fig:my_label}
\end{figure}

\begin{flushleft}
To calibrate the accelerometer, we need to change the orientation of the sensor between each $for$ loop to have each of the positive and negative axis pointing downwards. As per instructions in the Data sheet the full range of readings on each axis should be 2$g$. 

The second initialization step is to align the axis for gyroscope and accelerometer before using the readings for any further calculations.
The direction of the x,y,z axis is pre-set by factory, however it will not be the same for all sensors and since we are using a complimentary filter to fuse the measurements, it is crucial to make sure that the positive direction gyroscope and accelerometer axis are the same and that the positive angle of rotation matches the references used in motor control. \newline
During testing one of the Seeed Xiao micro-controllers was damaged and had to be swapped for a new one. It turned out that on the new micro-controller board the direction of y axis was the opposite for both sensor units and as a result was affecting the filtered sensor readings and the control algorithm. \newline

We introduce several functions needed for our positional calculations:
$ReadGyrof(), readAccf():$\newline
All sensor readings are stored in arrays of 3 float elements - one for each axis reading and since the readings from previous iteration are necessary for the digital filtering, before fetching the new sensor output values, old ones are shifted in a separate array.

$CalcAngleGyroF():$\newline
Calculates the Euler angles by "integrating" the gyroscope readings. It takes the last known angle of attitude and adds the current angular velocity times the time step of the full control loop. We can use this method since the drone will be launched from horizontal position therefore we can assume the inital angle value to be 0.

\begin{figure}[H]
    \begin{center}
    
    \end{center}
    \caption{CalcAngleGyroF() function}
    \label{fig:my_label}
\end{figure}

\begin{flushleft}
$UnfiltAngleGyroF(), UnfiltAngleGyroPrevF():$\newline
Needed for the digital filter - calculates unfiltered attitude angles based on current and previous gyroscope readings.

$CalcPhiAccF(), CalcThetaAccF():$\newline
Calculates Phi and Theta from Accelerometer readings interpreting full range of motion to be from $-\Pi$ to $\Pi$.

\begin{figure}[H]
    \begin{center}
    
    \end{center}
    \caption{CalcThetaAccF() function}
    \label{fig:my_label}
\end{figure}

\begin{flushleft}
$HPFGyroAngleF(), LPFAccAngleF():$\newline

Calculates the values filtered via digital filters. Based on the following discrete time implementation of high pass/ low filters explained earlier in the document:
\end{flushleft}
$y(t)=a_o y_n_-_1+b_ox_n+b_1x_n_-_1  $

\begin{flushleft}
we can create a function to carry out this calculation, where $y_n_-_1$ is the previous filtered value, $x_n$ is the unfiltered value based on current readings and $x_n_-_1$ is the unfiltered value based on previous readings. The structure of both high pass and low pass filters is the same, however the coefficients calculated by the Bilinear transform differ. Most notably - the 
$b1$ coefficient for High pass filter is negative.

\begin{figure}[H]
    \begin{center}
    
    \end{center}
    \caption{HPFGyroAngleF() function}
    \label{fig:my_label}
\end{figure}

\begin{figure}[H]
    \begin{center}
    
    \end{center}
    \caption{Digital filter Bilinear transform coefficients}
    \label{fig:my_label}
\end{figure}

\begin{flushleft}
$ComplimentaryF():$\newline
Combines high pass and low pass filter output.

For the time of flight sensor we need to include the Adafruit_VL53L0X.h library and then the vertical ditance can be measured with the help of measure.RangeMilliMeter function. Howver we need to remember that the drone could be pitched and rolled thereofor to get an accurate hight, we need to triangulate the reafing based on the Roll and Pitch angles. This can be done with the help of rotational matrix as follows:

\begin{figure}[H]
    \begin{center}
    
    \end{center}
    \caption{Calculating Z position from time of flight sensor}
    \label{fig:my_label}
\end{figure}
\end{document}
