Oscilous/Ladybug/Code/Drone_motors.jpg

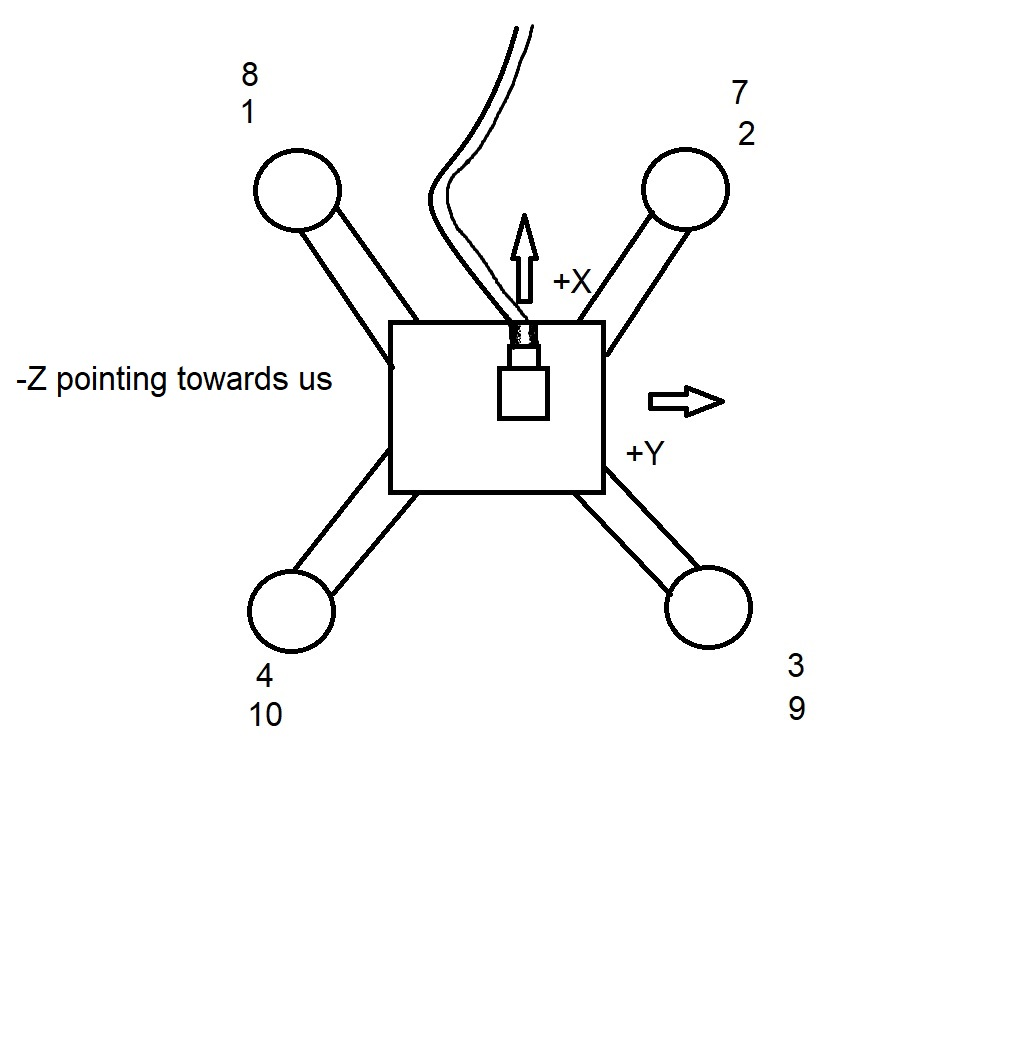
Code/Drone_motors.jpg
