Oscilous/Ladybug/Code/Main/v3/Libraries,png.PNG

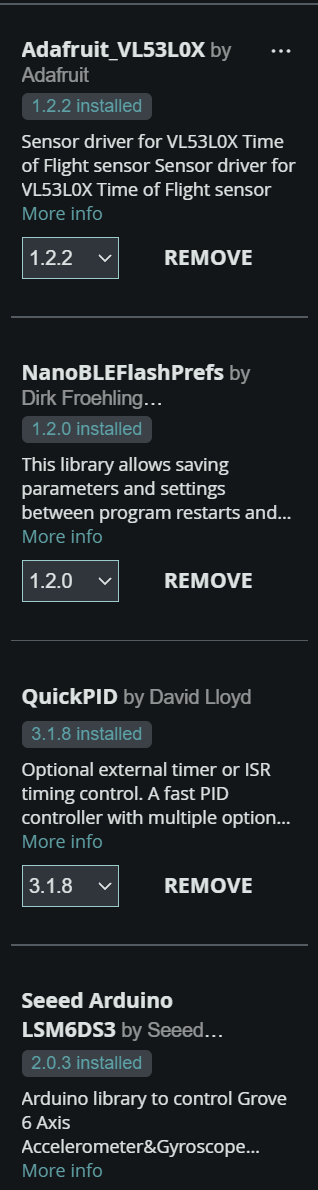
Code/Main/v3/Libraries,png.PNG
