Oscilous/Ladybug/LaTeX/Report/pictures/control/Drone view inertiacalc.png

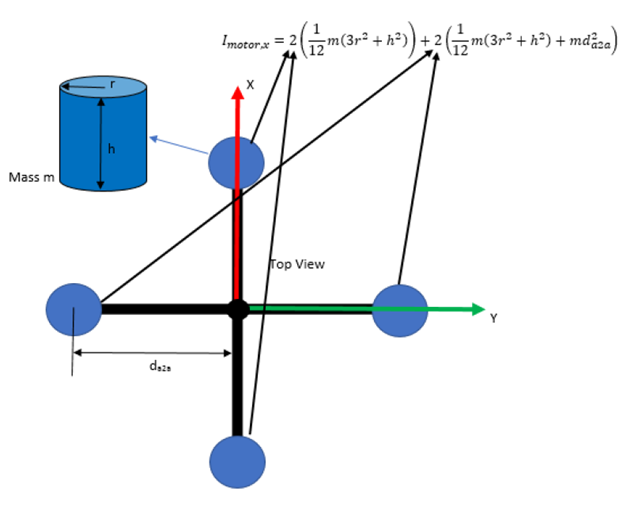
LaTeX/Report/pictures/control/Drone view inertiacalc.png
