Oscilous/Ladybug/LaTeX/Report/pictures/control/pidexample.jpeg

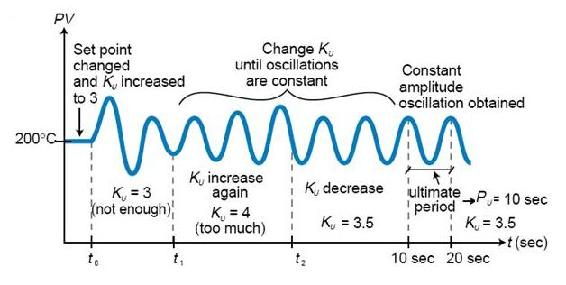
LaTeX/Report/pictures/control/pidexample.jpeg
