Oscilous/Ladybug/LaTeX/Report/pictures/design/w radii.png

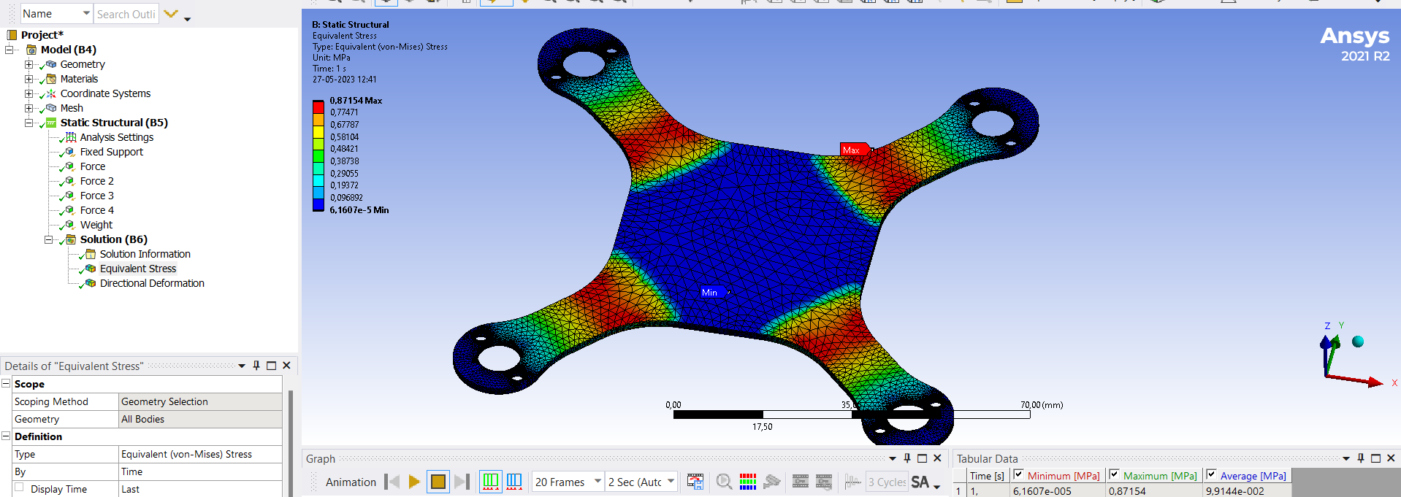
LaTeX/Report/pictures/design/w radii.png
