Oscilous/Ladybug/LaTeX/Report/pictures/design/wo radii.png

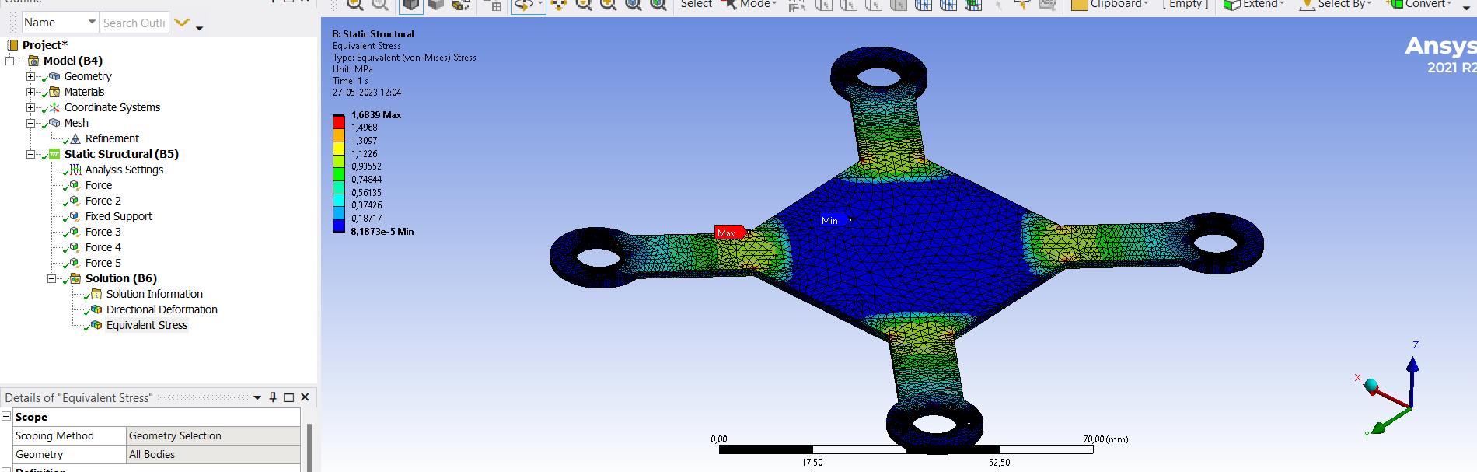
LaTeX/Report/pictures/design/wo radii.png
