Oscilous/Ladybug/LaTeX/Report/pictures/flowchart.png

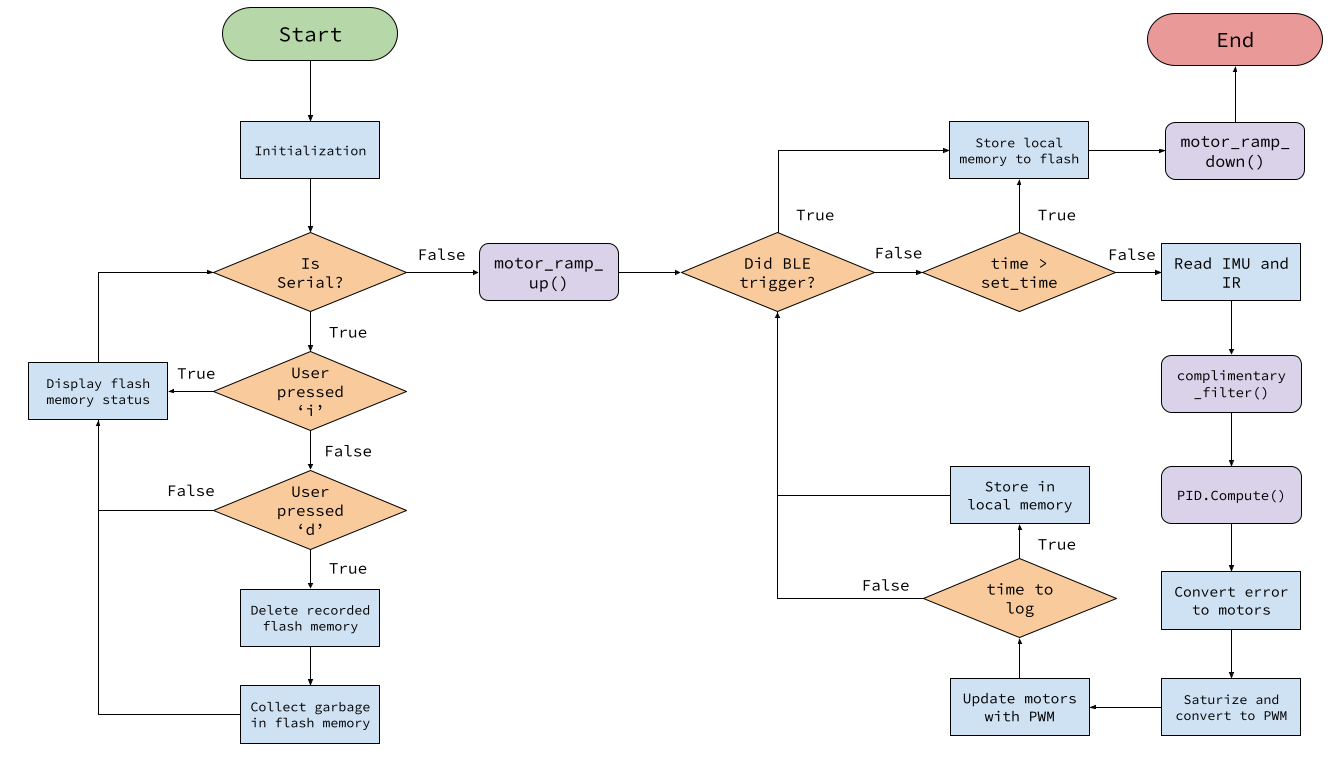
LaTeX/Report/pictures/flowchart.png
