Oscilous/Ladybug/LaTeX/Report/pictures/graphs/String08P5D.png

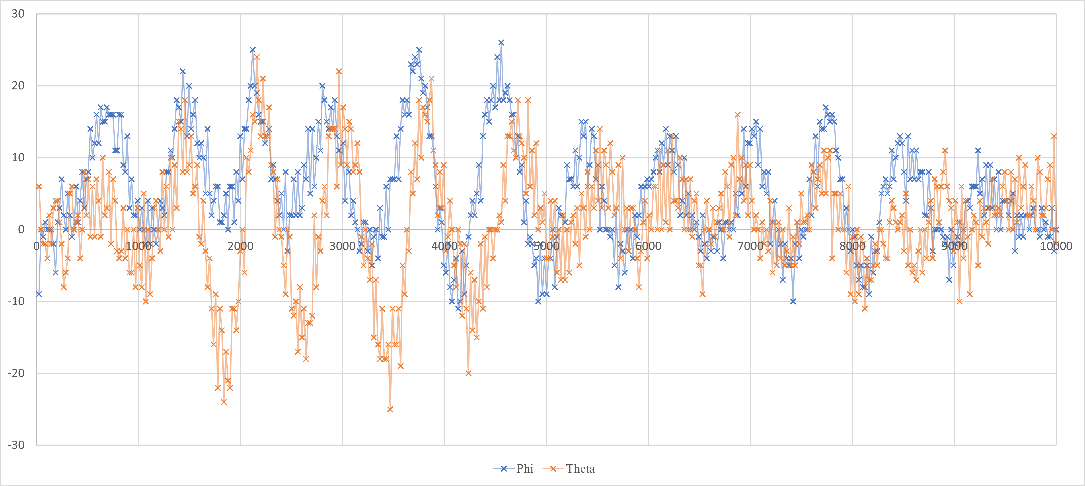
LaTeX/Report/pictures/graphs/String08P5D.png
