Oscilous/Ladybug/LaTeX/Report/pictures/graphs/String10P5D.png

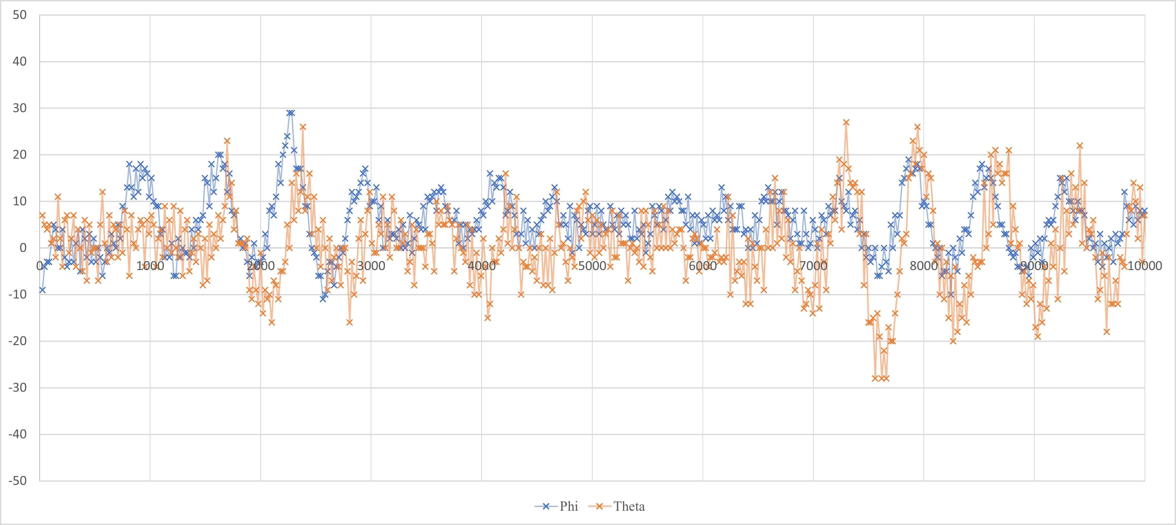
LaTeX/Report/pictures/graphs/String10P5D.png
