Oscilous/Ladybug/LaTeX/Report/pictures/graphs/String10P5DT4.png

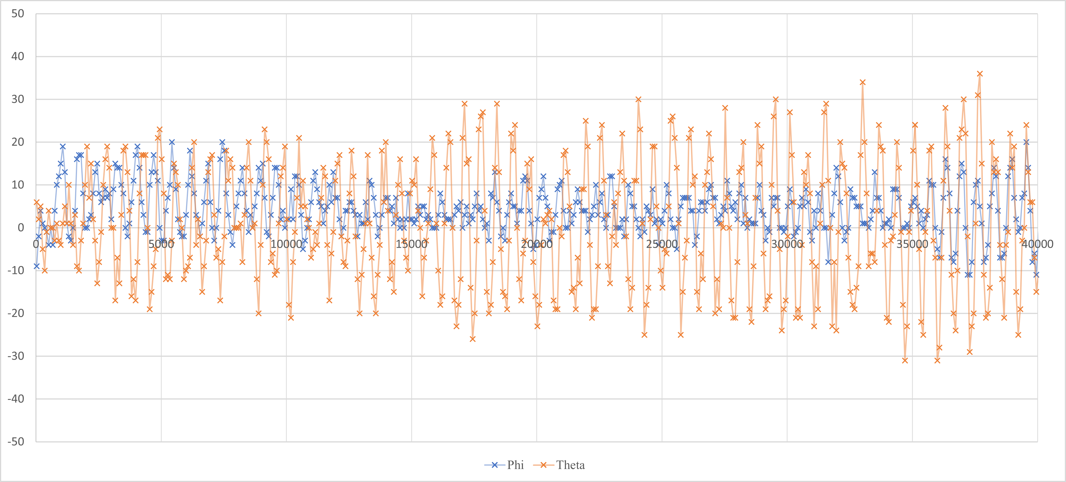
LaTeX/Report/pictures/graphs/String10P5DT4.png
