Oscilous/Ladybug/LaTeX/Report/pictures/graphs/String.png

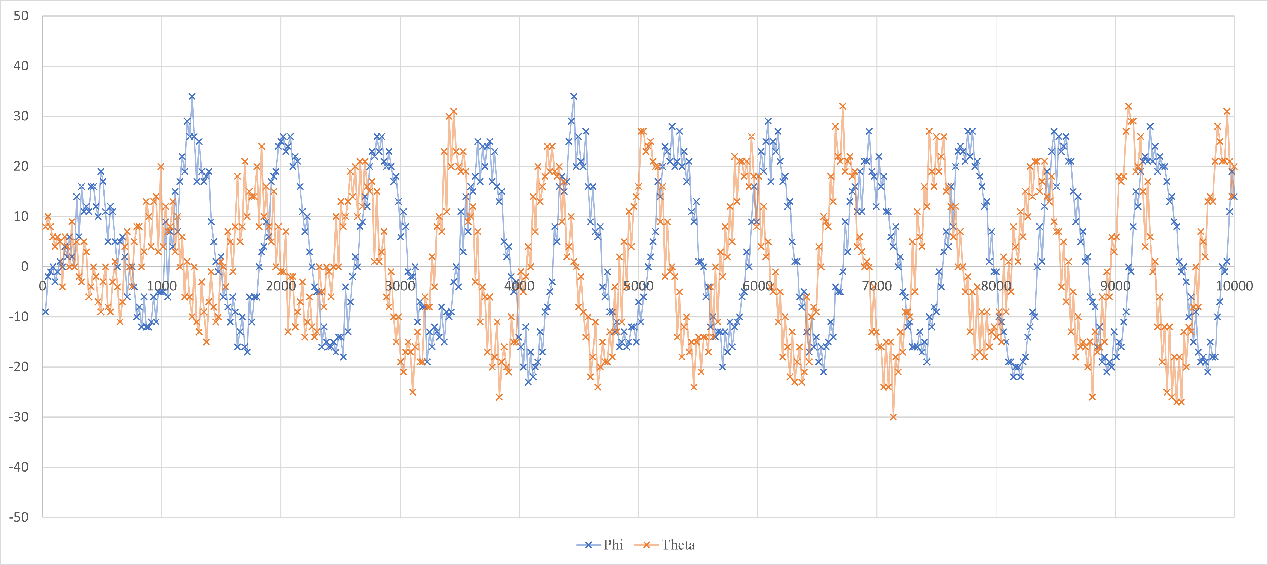
LaTeX/Report/pictures/graphs/String.png
