Oscilous/Ladybug/LaTeX/Report/pictures/graphs/ZN09P.png

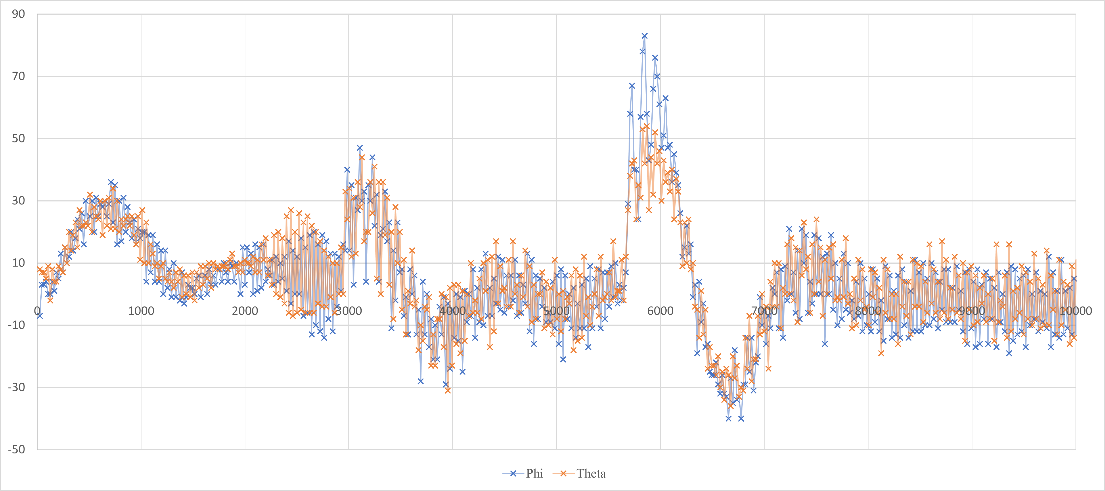
LaTeX/Report/pictures/graphs/ZN09P.png
