Oscilous/Ladybug/LaTeX/Report/pictures/IMU/Accel_0grav.png

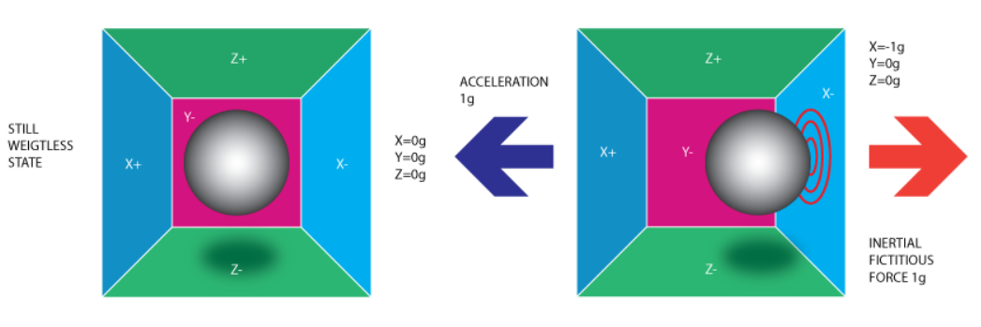
LaTeX/Report/pictures/IMU/Accel_0grav.png
