Oscilous/Ladybug/LaTeX/Report/pictures/IMU/Accel_rotate45.png

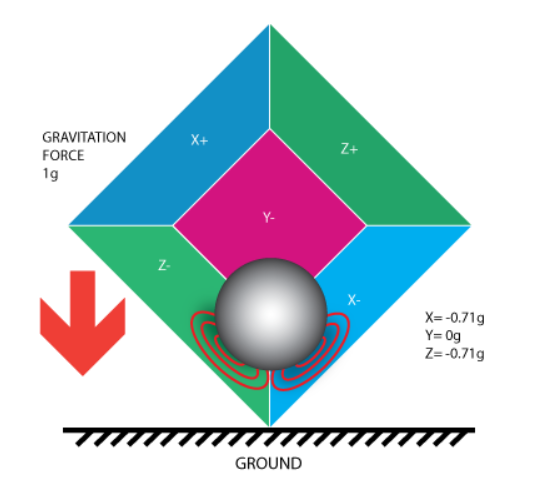
LaTeX/Report/pictures/IMU/Accel_rotate45.png
