Oscilous/Ladybug/LaTeX/Report/pictures/IMU/gyro_calculation_approximation.png

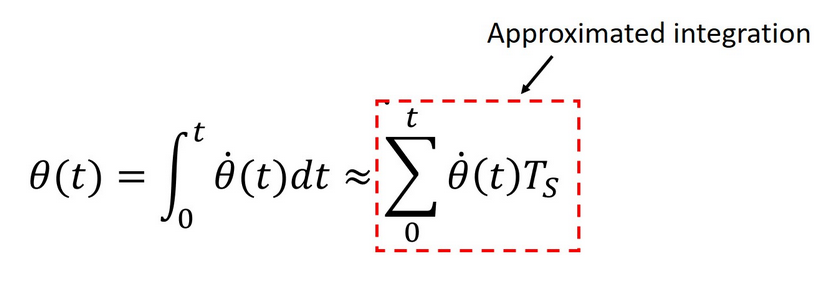
LaTeX/Report/pictures/IMU/gyro_calculation_approximation.png
