Oscilous/Ladybug/LaTeX/Report/pictures/IMU/gyro_plant.png

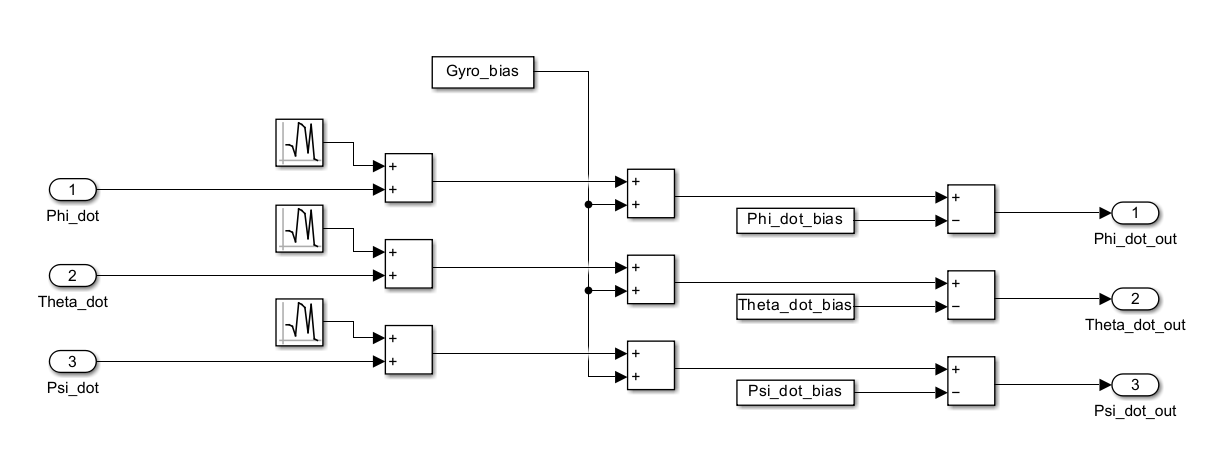
LaTeX/Report/pictures/IMU/gyro_plant.png
