Oscilous/Ladybug/LaTeX/Report/pictures/IMU/low_pass_matlab.png

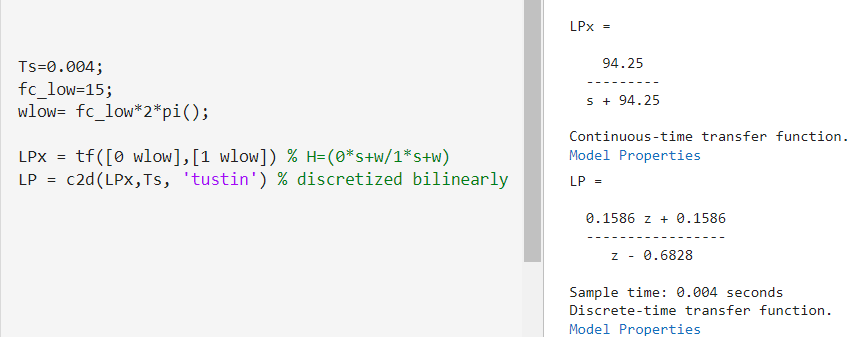
LaTeX/Report/pictures/IMU/low_pass_matlab.png
