Oscilous/Ladybug/LaTeX/Report/pictures/IMU/M5.png

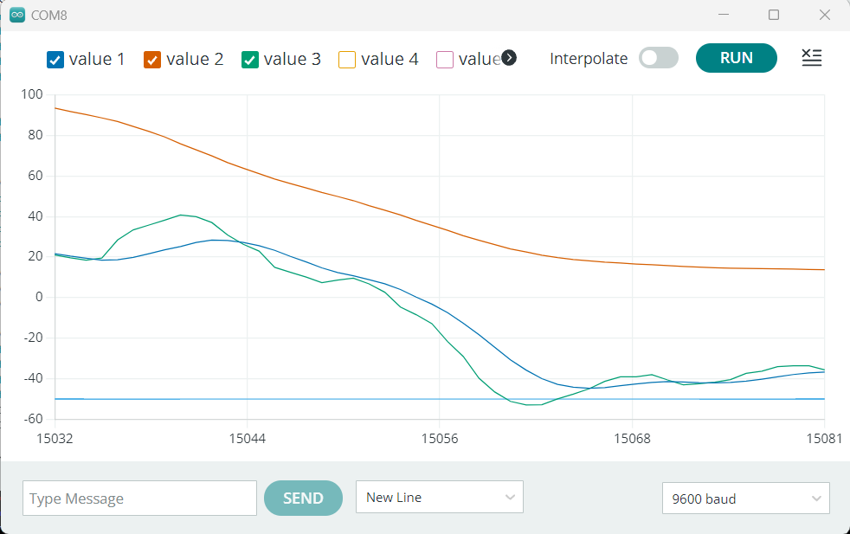
LaTeX/Report/pictures/IMU/M5.png
