Oscilous/Ladybug/LaTeX/Report/pictures/IMU/NED_to_body_function_block.png

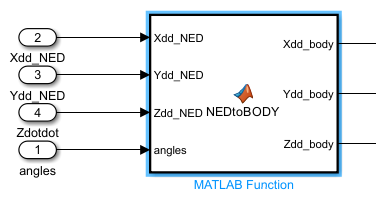
LaTeX/Report/pictures/IMU/NED_to_body_function_block.png
