Oscilous/Ladybug/LaTeX/Report/pictures/IMU/random number genreator.png

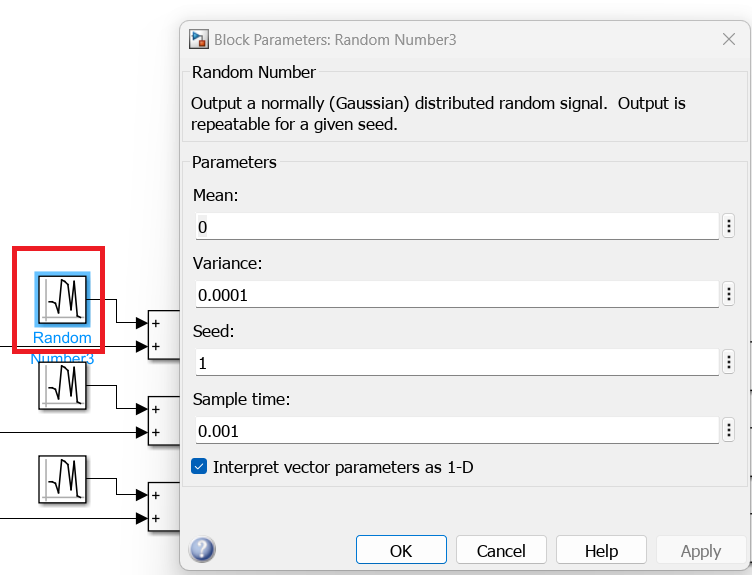
LaTeX/Report/pictures/IMU/random number genreator.png
