Oscilous/Ladybug/LaTeX/Report/pictures/IMU/Serial_monitor.png

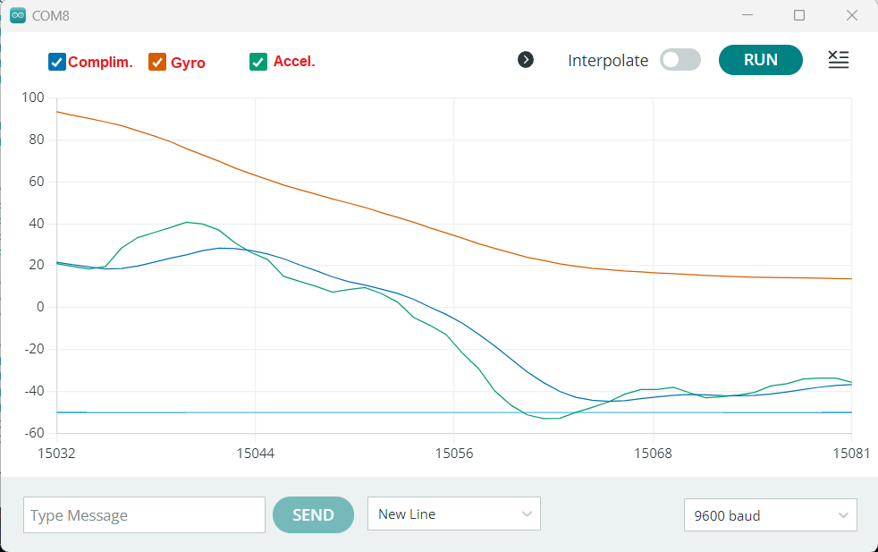
LaTeX/Report/pictures/IMU/Serial_monitor.png
