Oscilous/Ladybug/LaTeX/Report/pictures/serial_monitor.png

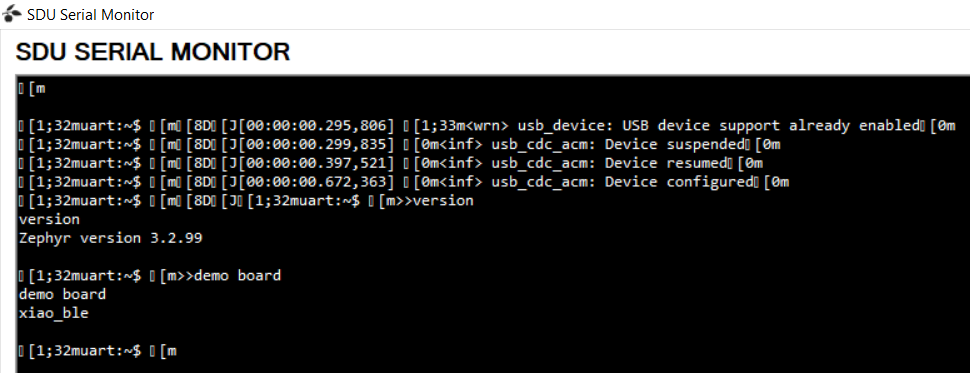
LaTeX/Report/pictures/serial_monitor.png
