Oscilous/Ladybug/Code/Main/v2/phi/logs/hover calibration.xlsx

Sheet: p=0.0045
25 | 8 | -30
45 | 0 | -21
65 | 0 | -21
85 | -3 | -18
105 | -3 | -19
126 | 2 | -24
146 | 0 | -22
166 | -4 | -17
186 | 0 | -21
206 | -1 | -20
226 | -1 | -20
246 | 3 | -24
266 | 0 | -21
286 | -4 | -17
306 | 0 | -21
326 | 2 | -24
346 | -1 | -20
366 | 4 | -25
386 | 4 | -26
406 | -2 | -19
427 | 7 | -28
447 | 8 | -29
467 | 3 | -25
487 | 7 | -28
507 | 13 | -35
527 | 18 | -39
547 | 17 | -38
567 | 18 | -39
587 | 20 | -41
608 | 19 | -40
628 | 16 | -37
648 | 16 | -37
668 | 18 | -39
688 | 18 | -39
708 | 18 | -39
728 | 15 | -36
748 | 13 | -34
768 | 7 | -29
788 | 7 | -29
808 | 9 | -31
828 | 4 | -25
848 | 6 | -28
869 | 4 | -26
889 | 2 | -24
909 | -9 | -12
929 | -12 | -10
949 | -5 | -17
969 | -8 | -13
989 | -17 | -5
1009 | -11 | -11
1029 | -13 | -9
1049 | -26 | 2
1069 | -21 | -1
1089 | -18 | -4
1109 | -21 | -1
1130 | -17 | -5
1150 | -17 | -5
1170 | -14 | -8
1190 | -13 | -8
1210 | -18 | -3
1230 | -14 | -8
1250 | -12 | -10
1270 | -14 | -8
1290 | -9 | -12
1310 | -16 | -6
1330 | -12 | -9
1350 | -13 | -8
1371 | -16 | -6
1391 | -15 | -7
1411 | -14 | -8
1431 | -18 | -4
1451 | -15 | -7
1471 | -12 | -9
1491 | -19 | -3
1511 | -8 | -13
1531 | -13 | -8
1551 | -16 | -5
1571 | -14 | -8
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
