Oscilous/Ladybug/LaTeX/Report/introduction/risk_assesment.tex

\subsection{Risk Assesment}

To ensure the safety under operation and development of the drone, a risk assessment is created for the drone project, based on the Fine \& Kinney method \cite{finekinney}.

\begin{figure}[H]
    \begin{center}
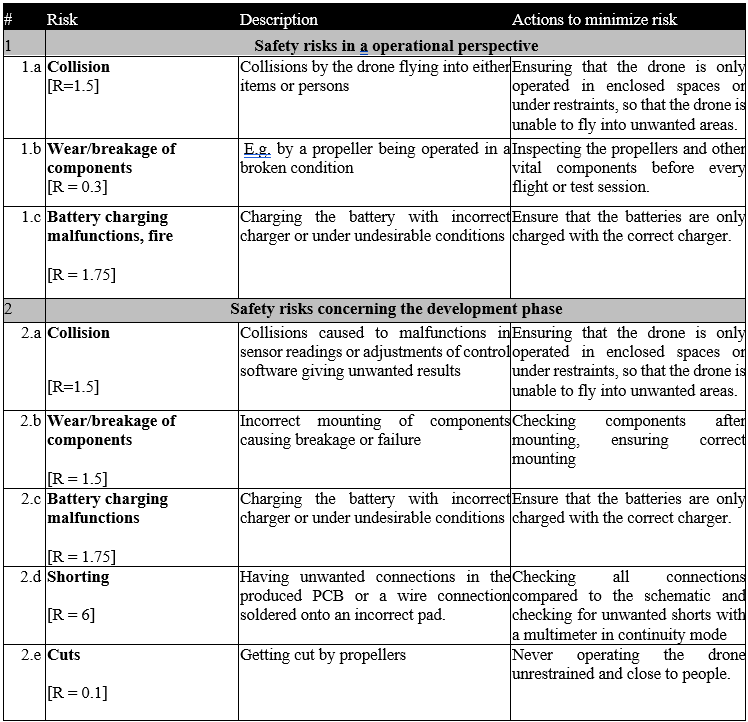
[picture p100: LaTeX/Report/pictures/Risk assesment table.png]
    
    \end{center}
    \caption{Risk assesment table}
    \label{Risk assesment table}
\end{figure}

Marked in all the risks are the risk scores calculated by the Fine \& Kinney method of Risk, Risk score = Probability * Exposure * Consequence. These risk scores are then compared in the risk clusters of the method, with five defined classes. After calculating the proposed risk ratings of the found risks, it’s apparent that all risks fall under the lowest factor of the Fine \& Kinney method of scores the: ‘Risk; Perhaps acceptable category’.
