Oscilous/Ladybug/LaTeX/Report/pictures/flowchart_pdf.pdf

Start | End

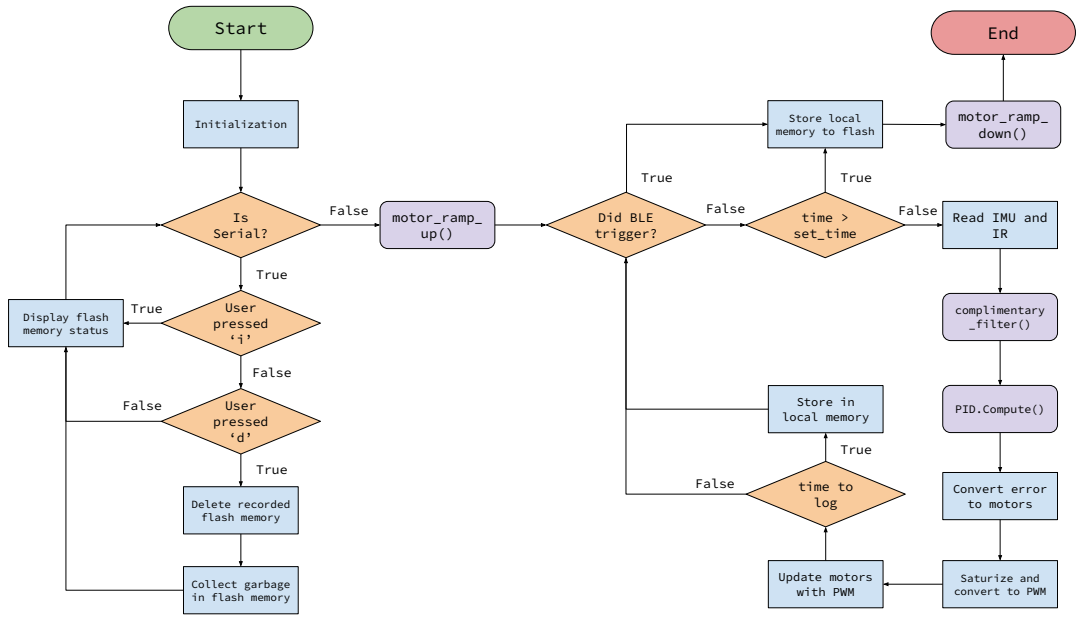
[picture p101: page 1]
Is Serial?; False; True; Initialization; Delete recorded flash memory; User pressed ‘i’; User pressed ‘d’; Display flash memory status; motor_ramp_ up(); time > set_time; complimentary _filter(); PID.Compute(); Update motors with PWM; time to log; Store in local memory; motor_ramp_ down(); Convert error to motors; Did BLE trigger?

Store local
memory to flash

Read IMU and

Saturize and
convert to PWM

Collect garbage
in flash memory
