Oscilous/Ladybug/(commit log)

2023-03-05 Add files via upload
    The configured files for XIAO BLE for use via nRF SDK, VSCode.
    To be added in ~\ncs\v2.3.0-rc1\zephyr\boards\arm
2023-05-07 Updated simulink
    Added the newest version, including the controller.
    [Lab tests.xlsx]
2023-05-12 Simulink is life :)
    [Lab tests.xlsx]
2023-05-14 Cleaning up
    [Lab tests.xlsx]
2023-05-17 Added PID for Z with IMU noise
2023-05-17 Cancelled out Psi PID
2023-05-17 Starting on pitch
2023-05-17 Continueing PID Phi
2023-05-18 Calibrated PID :)
2023-05-22 Arduino code (Flash+PID)
2023-05-24 Added .csv with two impulses
    [two impulses.csv]
2023-05-24 Linearization :hamburger: :
    [plots.xlsx, two impulses.csv]
2023-05-25 Finished theta
    [225.xlsx, 255 calib.xlsx, 255.xlsx, Logging and sampling.xlsx, hover calibration.xlsx, plots.xlsx]
2023-05-26 Phi and theta plz
    [fixed T.xlsx, string.xlsx]
2023-05-27 Cleaning and sorting
    [225.xlsx, 255 calib.xlsx, 255.xlsx, Logging and sampling.xlsx, fixed T.xlsx, hover calibration.xlsx, string.xlsx]
2023-05-30 Starting theory of PID
2023-05-30 Simulation of PID
2023-05-30 Added flowchart
2023-05-31 Finished linearization and simulation of PID
2023-05-31 Finished operation flow
2023-05-31 Added wireless, but needs change
2023-05-31 Added wireless
2023-05-31 Fixed wireless
2023-05-31 Added motor_testing to appendix
2023-06-01 Add files via upload
    Images for IMU report
2023-06-01 Add files via upload
    Images for IMU
2023-06-01 Add files via upload
    IMU report
2023-06-01 Create IMU.tex
    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
2023-06-01 Fixing PID
2023-06-01 Create IMU.tex
    new code
2023-06-01 Update main.tex
    updated with IMU
2023-06-01 IMU work
2023-06-01 Started fixing the IMU
2023-06-01 Changes to imu and conclusion
2023-06-08 Slight clean up
    [225.xlsx, 255 calib.xlsx, 255.xlsx, Book1.xlsx, Logging and sampling.xlsx, fixed T.xlsx, hover calibration.xlsx, string.xlsx]
2023-06-08 Tidying up
    [225.xlsx, 255 calib.xlsx, 255.xlsx, Book1.xlsx, Logging and sampling.xlsx, fixed T.xlsx, hover calibration.xlsx, string.xlsx]
